kuro68k/led_driver/debug.txt

Stations:	886/887		Radio 2?
			894/895		Radio 1?
			930/931
			962
			976/977 *	Heart
			983/984
			1004/1005
			
Scan:
977 67		Heart		interference?
976 67
975 63
978 61
983 60		R4?
1005 60		Classic
984 60
1004 59		Classic		good
930 55
909 54

RDA

C365 054A 9AB4 7420

1100 0011 0110 0101
Country: GB
Coverage: ???
Prog ref: local radio

0000 0101 0100 1010
type: 0A
CC: 0b10	2

1001 1010 1011 0100
AF

0111 0100 0010 0000
116 32	t_

C365 054F 9464 25A4

****t_

ABCD C465 054F CDCD 2020
ABCD C465 0548 E964 4865
ABCD C465 0549 A064 6172
ABCD C465 054A 9564 7420
ABCD C465 054F 9464 2020
ABCD 92CA 0548 645C 4865
ABCD C465 0549 CDCD 6104
ABCD C465 054A E964 740C
ABCD C465 054F A064 2020
ABCD C465 0548 9564 4865
ABCD C465 0549 9244 6172
ABCD C465 054A 645C 7420
ABCD C465 054F CDE0 2020
ABCD C465 0548 E964 4865
ABCD C465 0549 A064 6172
ABCD C465 0511 9564 7420
ABCD C465 054F 9464 2020
ABCD 5204 02A4 322B 2402
ABCD 5204 0556 9B9B C2E5

Block ABCD
3080 24
08E1 9443 2075 D406

					Ver Type
0B1A 95BC 4B51 D233  A	Em
B2E4 9B14 4A69 5278  B	Open
C598 4780 7684 3485  A	Time
0111 0110 1000 0100 0011 0100 1000 0101
dddd dddd dddd dddh hhhh mmmm mm+o oooo
d = 15170
h = 3
m = 18
o = 5 = 2.5 hours

4A6E 8418 9424 B8B2  A	Traf
1EE2 8986 0589 52DC  B	Open
08E1 9443 2075 D406  A	Em

16:57 4/8/2017 (MJD 57971)
ABCD 84A6 002C 2A0E 2505
ABCD AC38 F7A0 709A 0B49
ABCD A020 411C 6770 AB2C time
1100 0110 0111 0111 0000 1010 1011 0010 1100
  dd dddd dddd dddd dddh hhhh mmmm mm+o oooo

ABCD A020 364E 8345 AC0C
ABCD D575 7850 1999 3749
ABCD 35E6 1007 0407 7235
ABCD 0B20 881B 1F1F 0925
ABCD A912 E12E D251 6C19
ABCD 39A6 062B F80B 9498

17:02
423F 4986 8C2C 4E45
0110 1000 1100 0010 1100 0100 1110 0100 0101
  dd dddd dddd dddd dddh hhhh mmmm mm+o oooo
d = 41739
h = 4
m = 57
o = 2.5 hours

D3DA 4A41 24E9 2581
0001 0010 0100 1110 1001 0010 0101 1000 0001
  dd dddd dddd dddd dddh hhhh mmmm mm+o oooo

0x5		86AD	1000 0110 1010 1101
				ISEEK---- P-I- VOL-

TUNING:  4FCF	0100 1111 1100 1111
				CHAN--------DT BBSS	band=65-76 space=25kHz
				885-760=125 1111101
		
		 4FC8	0100 1111 1100 1000
				CHAN--------DT BBSS	band=76-108 space=100kHz

want	 1F58	0001 1111 0101 1000
				CHAN--------DT BBSS	band=76-108 space=100kHz

got (OK) 1F48	0001 1111 0100 1000
				CHAN--------DT BBSS	band=76-108 space=100kHz

seek	 4FC0	0100 1111 1100 0000
				CHAN--------DT BBSS

guide	 1A10	0001 1010 0001 0000
				CHAN--------DT BBSS 97.4MHz, tune

CTRLA seek 0309	0000 0011 0000 1001
				ZMMB RDUS MCLK RMRE SEEK_UP SEEK RDS_ON ENABLE

seek	 0329	0000 0011 0010 1001
				ZMMB RDUS MCLK RMRE

seek	 0309	0000 0011 0000 1001
				ZMMB RDUS MCLK RMRE

STATUSA: 013F	0000 0001 0011 1111
				RCFR ESCHAN--------

got		 407D	0100 0000 0111 1101
				RCFR ESCHAN--------

		 400F	0100 0000 0000 1111
				RCFR ESCHAN--------
				
STATUSB: 028F	0000 0010 1000 1111
				RSSI----T R..A AABB

guide	 1C95	0001 1100 1001 0101 RSSI=14
		 1D95	0001 1101 1001 0101 RSSI=14, FM TRUE
				RSSI----T R..A AABB
