kuro68k/led_driver/hardware/led_driver.pdf

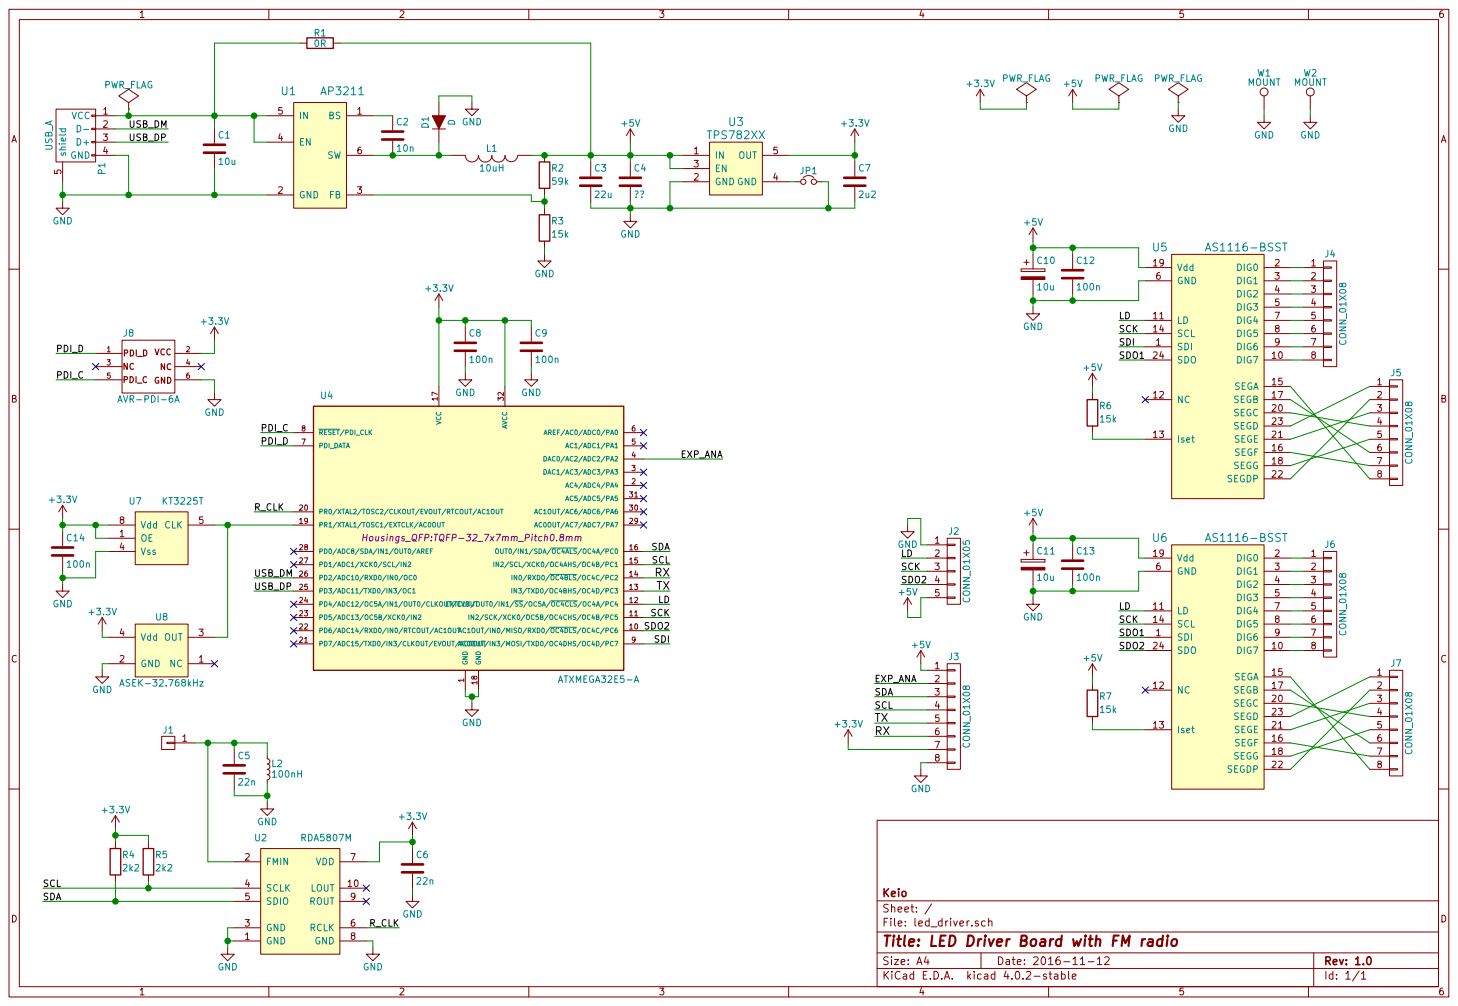
[picture p1: page 1]

1 AC4/ADC4/PA4 2 DAC1/AC3/ADC3/PA3 3 DAC0/AC2/ADC2/PA2 4 AC1/ADC1/PA1 5 AREF/AC0/ADC0/PA0 6 PDI_DATA 7 RESET/PDI_CLK 8 AC0OUT/IN3/MOSI/TXD0/OC4DHS/OC4D/PC7 9 AC1OUT/IN0/MISO/RXD0/OC4DLS/OC4C/PC6 10 PR0/XTAL2/TOSC2/CLKOUT/EVOUT/RTCOUT/AC1OUT 20 AC1OUT/AC6/ADC6/PA6 30

File: led_driver.sch Sheet: / Keio

Id: 1/1 Title: LED Driver Board with FM radio
