kuro68k/led_driver/hardware/V1.0/led_driver.kicad_pcb

## KiCad design hardware/V1.0/led_driver.kicad_pcb (2016-11-14)

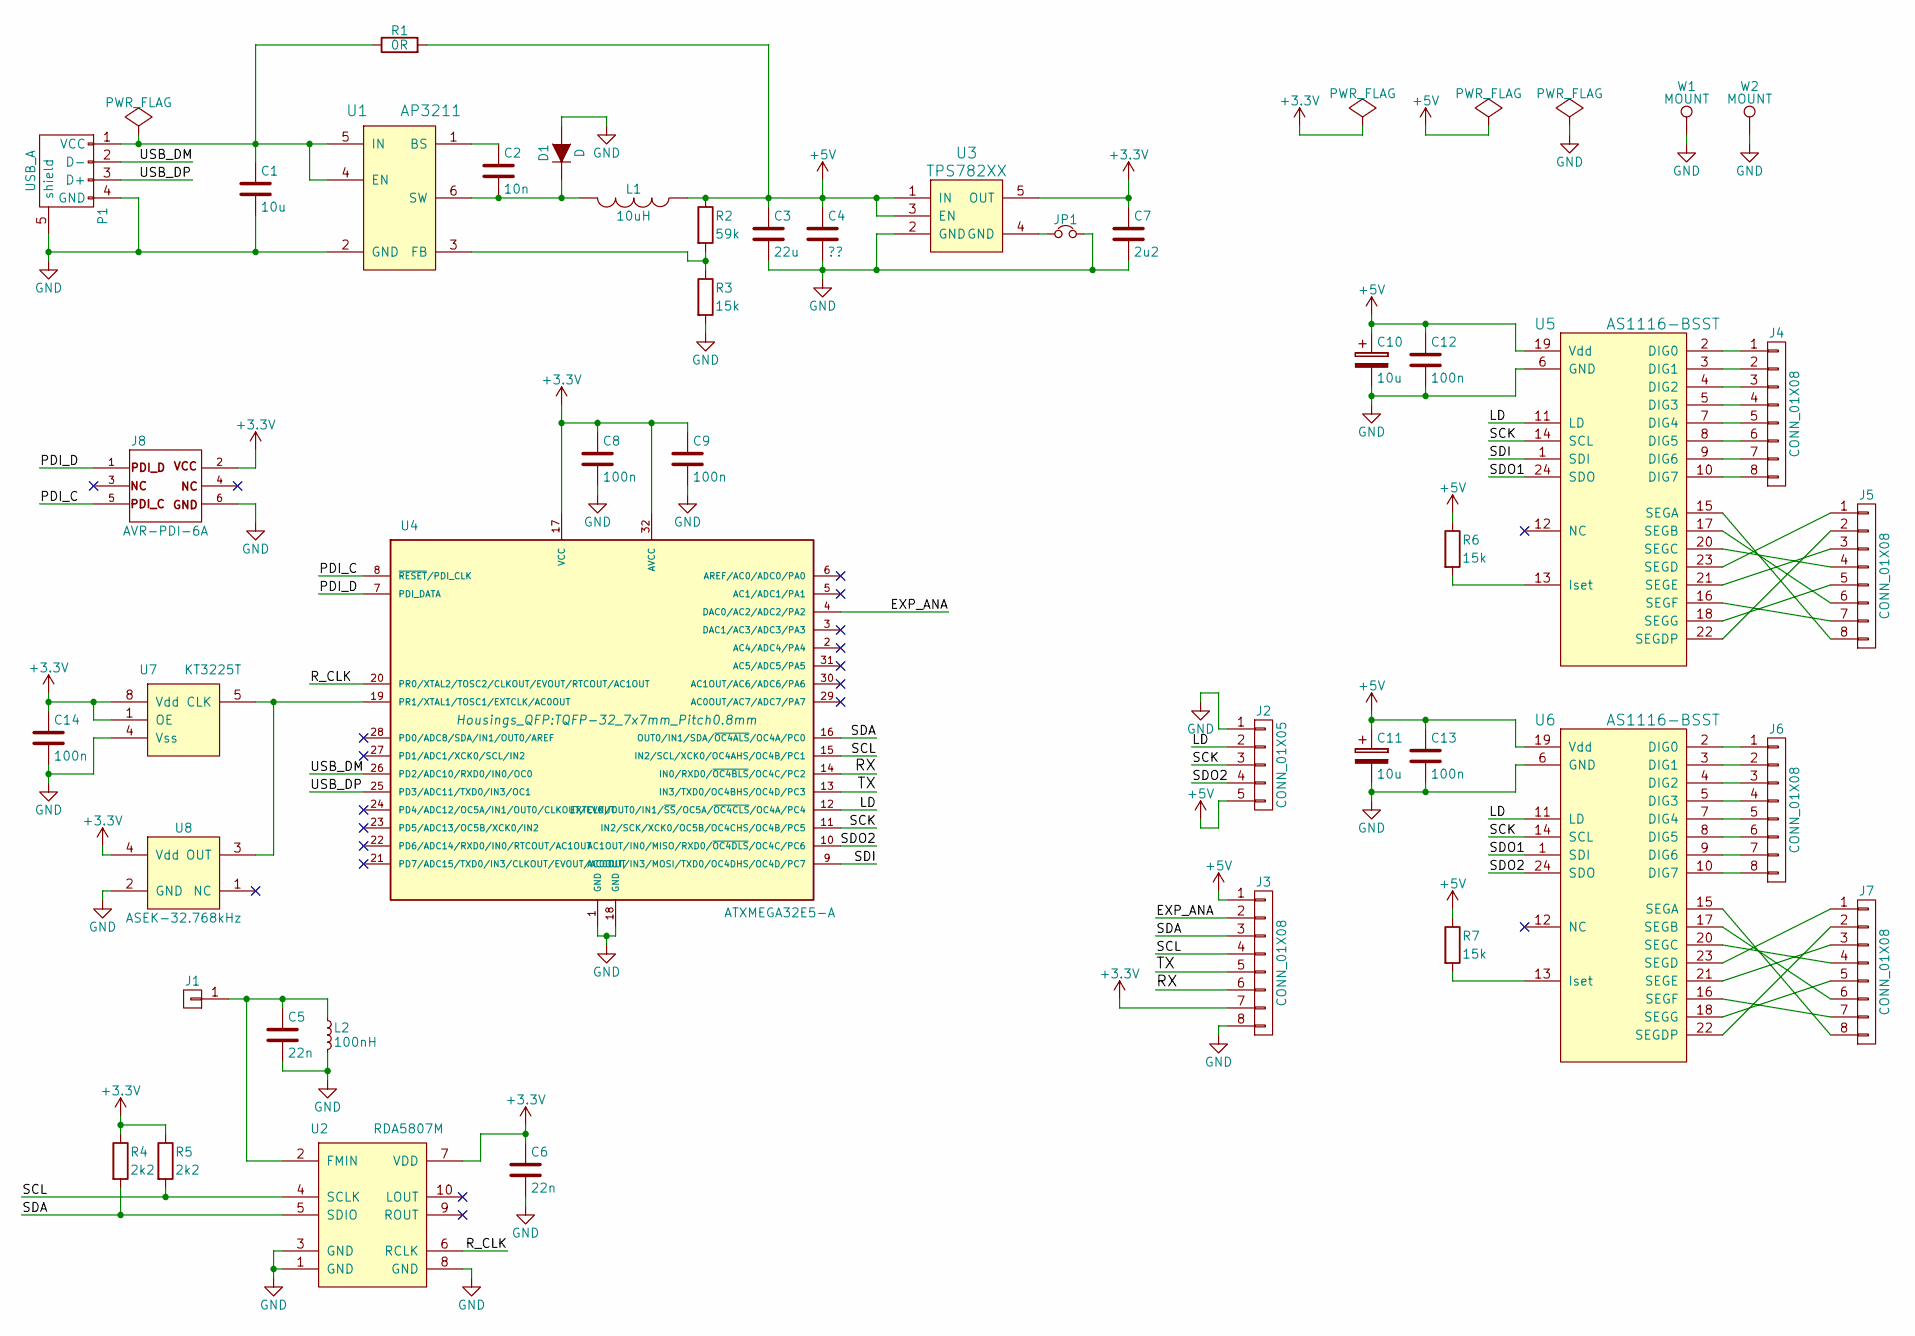
[picture p2: schematic led_driver.sch, LED Driver Board with FM radio]

Parts:
C1: 10u; C_0805
C2: 10n; C_0603
C3: 22u; C_0603
C4: ??; C_0603
C5, C6: 22n; C_0603
C7: 2u2; C_0603
C8, C9, C12, C13, C14: 100n; C_0603
C10, C11: 10u; SMD-1206_Pol
D1: D; SOD-323_HandSoldering
J1: CONN_01X01; Pin_Header_Straight_1x01
J2: CONN_01X05; B5B-ZR-SM4-TF
J3, J4, J5, J6, J7: CONN_01X08; B8B-ZR-SM4-TF
J8: AVR-PDI-6A; 3x2_1.27mm_SMD_header
JP1: Jumper_NC_Small; R_0603
L1: 10uH; Neosid_Inductor_SM-NE56_SMD2220
L2: 100nH; R_0603
P1: USB_A; Molex_47346-0001_Micro_USB_SMT
R1: 0R; R_0603
R2: 59k; R_0603
R3, R6, R7: 15k; R_0603
R4, R5: 2k2; R_0603
U1: AP3211; SOT-23-6
U2: RDA5807M; MSOP-10_3x3mm_Pitch0.5mm
U3: TPS782XX; SOT-23-5
U4: ATXMEGA32E5-A; TQFP-32_7x7mm_Pitch0.8mm
U5, U6: AS1116-BSST; SSOP-24_3.9x8.7mm_Pitch0.635mm
U7: KT3225T
U8: ASEK-32.768kHz; Crystal-3.2x2.5-ASEK-Series-Abracon
W1, W2: MOUNT; MountingHole_2.5mm_Pad

Connections:
+3V3: C6.1, C7.1, C8.1, C9.1, C14.1, J3.7, J8.2, R4.1, R5.1, U2.7 (VDD), U3.5 (OUT), U4.17 (VCC), U4.32 (AVCC), U7.1 (OE), U7.8 (Vdd), U8.4 (Vdd)
+5V: C3.1, C4.1, C10.1, C11.1, C12.1, C13.1, J2.5, J3.1, L1.1, R1.2, R2.1, R6.1, R7.1, U3.1 (IN), U3.3 (EN), U5.19 (Vdd), U6.19 (Vdd)
/EXP_ANA: J3.2, U4.4 (DAC0/AC2/ADC2/PA2)
/LD: J2.2, U4.12 (EXTCLK/OUT0/IN1/~SS~/OC5A/~OC4CLS~/OC4A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), U5.11 (LD), U6.11 (LD)
/PDI_C: J8.5, U4.8 (~RESET~/PDI_CLK)
/PDI_D: J8.1, U4.7 (PDI_DATA)
/RX: J3.6, U4.14 (IN0/RXD0/~OC4BLS~/OC4C/PC2)
/R_CLK: U2.6 (RCLK), U4.20 (PR0/XTAL2/TOSC2/CLKOUT/EVOUT/RTCOUT/AC1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)
/SCK: J2.3, U4.11 (IN2/SCK/XCK0/OC5B/OC4CHS/OC4B/PC5), U5.14 (SCL), U6.14 (SCL)
/SCL: J3.4, R5.2, U2.4 (SCLK), U4.15 (IN2/SCL/XCK0/OC4AHS/OC4B/PC1)
/SDA: J3.3, R4.2, U2.5 (SDIO), U4.16 (OUT0/IN1/SDA/~OC4ALS~/OC4A/PC0)
/SDI: U4.9 (AC0OUT/IN3/MOSI/TXD0/OC4DHS/OC4D/PC7), U5.1 (SDI)
/SDO1: U5.24 (SDO), U6.1 (SDI)
/SDO2: J2.4, U4.10 (AC1OUT/IN0/MISO/RXD0/~OC4DLS~/OC4C/PC6), U6.24 (SDO)
/TX: J3.5, U4.13 (IN3/TXD0/OC4BHS/OC4D/PC3)
/USB_DM: P1.2 (D-), U4.26 (PD2/ADC10/RXD0/IN0/OC0)
/USB_DP: P1.3 (D+), U4.25 (PD3/ADC11/TXD0/IN3/OC1)
GND: C1.2, C3.2, C4.2, C5.2, C6.2, C7.2, C8.2, C9.2, C10.2, C11.2, C12.2, C13.2, C14.2, D1.2 (A), J2.1, J3.8, J8.6, JP1.2, L2.2, P1.4 (GND), P1.5 (shield), R3.2, U1.2 (GND), U2.1 (GND), U2.3 (GND), U2.8 (GND), U3.2 (GND), U4.1 (GND), U4.18 (GND), U5.6 (GND), U6.6 (GND), U7.4 (Vss), U8.2 (GND), W1.1, W2.1
unnamed: C1.1, P1.1 (VCC), R1.1, U1.4 (EN), U1.5 (IN)
unnamed: C2.1, U1.1 (BS)
unnamed: C2.2, D1.1 (K), L1.2, U1.6 (SW)
unnamed: C5.1, J1.1, L2.1, U2.2 (FMIN)
unnamed: J4.1, U5.2 (DIG0)
unnamed: J4.2, U5.3 (DIG1)
unnamed: J4.3, U5.4 (DIG2)
unnamed: J4.4, U5.5 (DIG3)
unnamed: J4.5, U5.7 (DIG4)
unnamed: J4.6, U5.8 (DIG5)
unnamed: J4.7, U5.9 (DIG6)
unnamed: J4.8, U5.10 (DIG7)
unnamed: J5.1, U5.23 (SEGD)
unnamed: J5.2, U5.22 (SEGDP)
unnamed: J5.3, U5.21 (SEGE)
unnamed: J5.4, U5.20 (SEGC)
unnamed: J5.5, U5.18 (SEGG)
unnamed: J5.6, U5.17 (SEGB)
unnamed: J5.7, U5.16 (SEGF)
unnamed: J5.8, U5.15 (SEGA)
unnamed: J6.1, U6.2 (DIG0)
unnamed: J6.2, U6.3 (DIG1)
unnamed: J6.3, U6.4 (DIG2)
unnamed: J6.4, U6.5 (DIG3)
unnamed: J6.5, U6.7 (DIG4)
unnamed: J6.6, U6.8 (DIG5)
unnamed: J6.7, U6.9 (DIG6)
unnamed: J6.8, U6.10 (DIG7)
unnamed: J7.1, U6.23 (SEGD)
unnamed: J7.2, U6.22 (SEGDP)
unnamed: J7.3, U6.21 (SEGE)
unnamed: J7.4, U6.20 (SEGC)
unnamed: J7.5, U6.18 (SEGG)
unnamed: J7.6, U6.17 (SEGB)
unnamed: J7.7, U6.16 (SEGF)
unnamed: J7.8, U6.15 (SEGA)
unnamed: JP1.1, U3.4 (GND)
unnamed: R2.2, R3.1, U1.3 (FB)
unnamed: R6.2, U5.13 (Iset)
unnamed: R7.2, U6.13 (Iset)
unnamed: U4.19 (PR1/XTAL1/TOSC1/EXTCLK/AC0OUT), U7.5 (CLK), U8.3 (OUT)

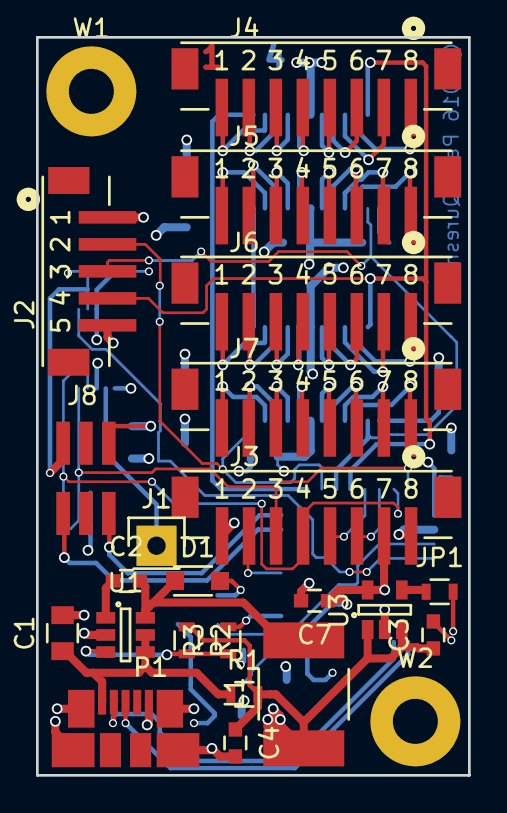
[picture p3: board led_driver.kicad_pcb from above]

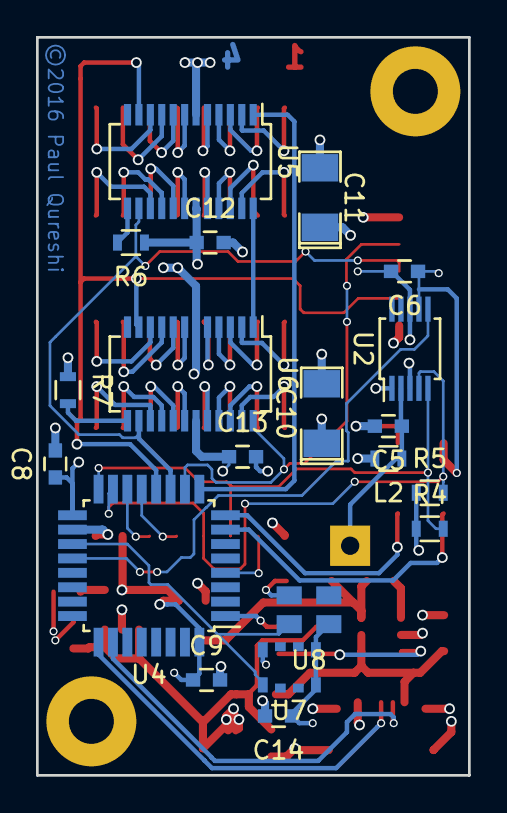
[picture p4: board led_driver.kicad_pcb from below]

Board: 4 copper layers, 24.0 x 41.0 mm, 44 parts (20 on the bottom side), 59 nets.
