kuro68k/led_driver/(commit log)

2016-11-11 Sorted out library references
    [led_driver.kicad_pcb, led_driver.sch]
2016-11-14 Preparing for production
    [led_driver.kicad_pcb, led_driver.sch]
2016-11-15 Ready for V1.0 release
    Converted schematic to A4 for ease of viewing
    [led_driver-B.Cu.gbl, led_driver-B.Mask.gbs, led_driver-Eco1.User.gbr, led_driver-Eco2.User.gbr, led_driver-Edge.Cuts.gm1, led_driver-F.Cu.gtl, led_driver-F.Mask.gts, led_driver.drl]
2016-11-27 BOM fixes
    [_saved_led_driver.sch]
2017-04-13 BOM output updates
    [_saved_led_driver.sch, led_driver.sch]
2017-07-29 RDA read OK
    [_saved_led_driver.sch, led_driver.sch]
