kuro68k/led_driver/(notices)

Notices in the files:
hardware/V1.0/led_driver.kicad_pcb:
©2016 Paul Qureshi
